derekdotrodeo/buddy-system/(commit log)

2026-06-14 Add card template and knob card
    [knob-buddy.kicad_pcb, knob-buddy.kicad_sch, knob_buddy.kicad_sch, template-card.kicad_pcb]
2026-06-14 Add BBP firmware stack (core, desktop platform, policy) and finalize specs
    Firmware (firmware/):
    - bbp-core: platform-independent C99 framing/CRC library — frame encode,
    byte-at-a-time RX assembler, CRC-16/CCITT-FALSE — with unit tests.
    - platforms/desktop: in-process RS-485 virtual-bus platform for
    hardware-free testing (deterministic clock, per-node RX queues).
    - bbp-policy: host + module policy layers — host-polled model, discovery,
    reserved-schema handling, protocol-before-events queue, bbp.error —
    with integration tests over the virtual bus.
    Specs (web/src/content/docs/):
    - BS-SPEC-100 v1.2: bus signaling (1 Mbit/s, 8N1, 2-wire half-duplex).
    - BS-SPEC-200 v1.3: ratified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
2026-06-14 Add desktop-demo example app
    A runnable program that exercises the full firmware stack on the desktop
    virtual bus with no hardware: a host discovers a POT-6 (slot 1) and a
    BTN-4 (slot 3), broadcasts bbp.start/stop, and polls each populated slot
    for controls.pot / controls.button events. Same policy + core code that
    runs on hardware, with only the platform swapped for the simulator.
    Also ignore compiled example binaries (firmware/.gitignore).
2026-06-14 Add RP2040 platform and host/peripheral examples
    firmware/platforms/rp2040: implements bbp_platform_t on the Pico SDK —
    UART tx (blocking until the wire is idle), a GPIO driving RS-485 DE/~RE,
    millis, SLOT-pin ADC -> slot-number mapping, and an interrupt-fed RX
    ring. The SLOT mapping is factored out (bbp_rp2040_slot.c) and
    unit-tested on the host.
    firmware/examples/rp2040-host and rp2040-peripheral: a bus master and a
    CTL-1 control module built on the policy layer, with wiring and
    build/flash instructions (README).
    Verified: the SLOT-mapping unit test passes on the host. The SDK-backed
    platform and examples are written against the Pico SDK but have not yet
    been built with the SDK or run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
2026-06-14 Add common schemas (BS-SPEC-300) and adopt them in the examples
    firmware/bbp-schemas: header-only codecs for the baseline application
    payload schemas — controls.pot, controls.button, controls.encoder,
    midi.message — with host unit tests.
    BS-SPEC-300 (web/src/content/docs/common-schemas.md): the catalog spec,
    framed as recommended-not-required; cross-referenced from BS-SPEC-200 §7
    (-> v1.4).
    Refactor the desktop and RP2040 examples to use the shared schema names
    and codecs instead of ad-hoc strings; pot values widened to 16-bit.
2026-06-15 Add docs and blog post
    [buddy-base-v1.kicad_pcb]
2026-06-21 Add MIDI buddy
    [midi-buddy.kicad_pcb, midi-buddy.kicad_sch, midi_buddy.kicad_sch, template-card.kicad_pcb]
2026-06-23 Update audio header labels
    [buddy-base-v1.kicad_pcb]
2026-06-28 Add new brains
    [brain-template.kicad_pcb, brain-template.kicad_sch, buddy-base-v1.kicad_pcb, buddy_audio.kicad_sch, daisy-brain.kicad_pcb, daisy-brain.kicad_sch]
2026-06-28 Update card template and MIDI Buddy
    [daisy-brain.kicad_pcb, daisy-brain.kicad_sch, midi-buddy.kicad_pcb, midi-buddy.kicad_sch, midi_buddy.kicad_sch, template-card.kicad_pcb, template-card.kicad_sch]
2026-06-29 Finish Line Buddy
    [line-buddy.kicad_pcb]
